open-electronics/RandA/Figures/BlocksStructure.jpg

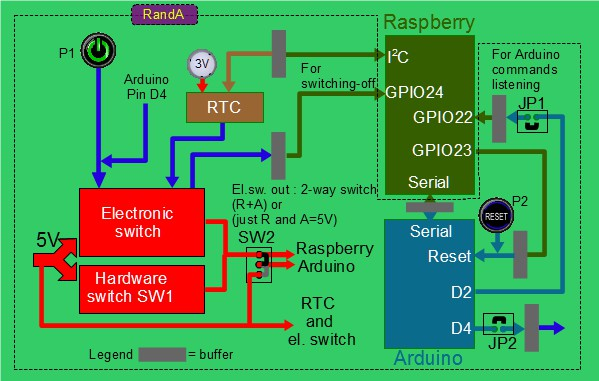
Figures/BlocksStructure.jpg
