open-electronics/RandA/ReadMe.txt

Last Version is V1.5 (use releases tab above to reach the software)
For detailed informations about hardware/software read pdf file

L'ultima versione è la V1.5 (usate il menu <releases> più sopra per raggiungerla)

USARE MENU "tags" o "releasese" PER ACCEDERE ALLE VERSIONI

***************************************************************

PLEASE NOTE that downloading files are in release directory!
So, **for downloading, open menu "releases" (see up there)**. 
This page is intended as a project description.
For this purpose see RandA-en.pdf file for more details.

**Version 1.5 is Raspberry Pi 3 , and Raspbian-jessie compliant**

USES MENU "tags" or "release" FOR VERSIONS LIST AND DOWNLOAD

****************************************************************

ATTENZIONE! Il downloading del software per RandA lo potete
trovare nelle varie cartelle di release.
**Per cui attivate la voce di menù "releases" (che vedete in alto)**.
Questa pagina è usata solo per introdurre il progetto RandA, 
di cui potete avere una visione approfondita tramite il file 
RandA-en.pdf (in Inglese).

**La versione 1.5 è compatibile con Raspberry Pi 3 e con Raspbian-jessie**

****************************************************************

RandA software distribution.

Two software for two environments.
- A zip file for PC. Extract directory (anywhere) on PC and read README.TXT file
  included.
- A zip file for Raspberry. You can copy this file to Raspberry and unzip it 
  there, or you can unzip locally and copy archive and installation script later.
  Read the InstallationREADME.TXT file included.
  
  But since version 1.4 you can download, also, a complete and configured SD image for Raspberry Pi.
  
An handbook with a complete description of RandA (RandA-en.pdf) is included.    

N.B. A copy of PC archive and documentation is also contained in archive for 
Raspberry and extracted to /home/pi/RandA directory for backup. 

These procedures for upgrading your Raspbian OS, already installed, and for upgrading
Arduino IDE, are the shortest software to download (single zip file of about 20M).
But, if you like, you can use a complete Raspbian image (with RandA software)
to download and install, on your SD card.
And you can download, also, the entire Arduino IDE modified.
Using these longer downloads, you are directly operating, without installation
procedure. But you lose your already installed software (if any) and you need to 
install it again.

More info on open-electronics site
http://www.open-electronics.org/tag/randa/
