open-electronics/RandA/Figures/Reset.jpg

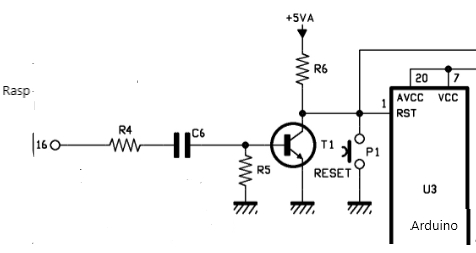
Figures/Reset.jpg
