open-electronics/RandA/Figures/SchematicTot.jpg

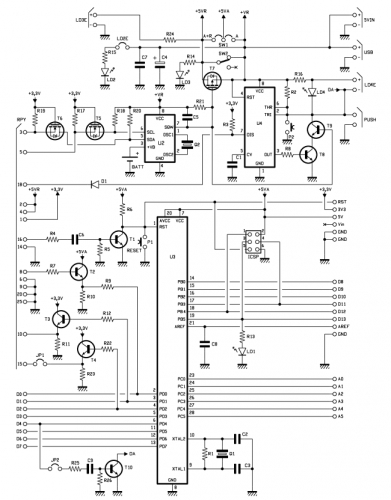
Figures/SchematicTot.jpg
