open-electronics/RandA/(threads)

Thread 1 (2015-06-18):

file remoteport.properties for RandA on Mac machine

gelatmi1, 2015-06-18:
Where i have to copy the file remoteport.properties on a Mac machine (of course if it's possible to use the modified Arduino 1.0.5 on Mac) ?
Thanks

danieledenaro, 2015-06-19:
Same as in Windows environment (where Arduino.exe is executed). I don't know Mac environment so good that I can be sure, but Arduino is a Java based application, so it is portable and directories are the same (I suppose).

gelatmi1, 2015-06-19:
Thanks (grazie) Daniele.
I will try to find the right directorie s.

gelatmi1, 2015-06-27:
Try to instal RandA software on Raspy PI 2 but after reboot i receive a lot of bad messages (like processor 3 stopping) and at the end Kernel stopped with panic alert / not able to mount device ..... and the system is freeze !!!

danieledenaro, 2015-06-27:
xgelatmi1
Try to install RandA software on a new SD with Raspbian. Probably some interaction with other installed software. Or download and use SD image with software installed, on a new SD (via WinDiskImager).
Software has been tested on Raspy Pi 2.

gelatmi1, 2015-06-27:
No other software installed, it is a fresh installation using NOOBS to install it on a 32 GB SD cardI changed only the hostname and added cgroup_enable=memory to file cmdline.txt

Date: Sat, 27 Jun 2015 01:43:24 -0700
From: notifications@github.com
To: RandA@noreply.github.com
CC: gelmir99@hotmail.com
Subject: Re: [RandA] file remoteport.properties for RandA on Mac machine (#1)

xgelatmi1

Try to install RandA software on a new SD with Raspbian. Probably some interaction with other installed software. Or download and use SD image with software installed, on a new SD (via WinDiskImager).

Software has been tested on Raspy Pi 2.

—
Reply to this email directly or view it on GitHub.

danieledenaro, 2015-06-27:
xgelatmi1
Simply, try to disable cgroup (comment line). Not tested with RandA software.
If no more problems, I will investigate about cgroup and RandA (but not immediately).

gelatmi1, 2015-06-27:
i will try this evening but i'm not sure this is the solution because in your procedure this file is substitute with a new one if i remember well
thanks for your help

Date: Sat, 27 Jun 2015 02:15:25 -0700
From: notifications@github.com
To: RandA@noreply.github.com
CC: gelmir99@hotmail.com
Subject: Re: [RandA] file remoteport.properties for RandA on Mac machine (#1)

xgelatmi1

Simply, try to disable cgroup (comment line). Not tested with RandA software.

If no more problems, I will investigate about cgroup and RandA (but not immediately).

—
Reply to this email directly or view it on GitHub.

danieledenaro, 2015-06-27:
xgelatmi1

In any case for people that should have problem with RandA installation procedure, I suggest to try to install on new OS image, or better, to use image already prepared downloaded from github site (release 1.4).
In this way you can add, step by step, software or setting added, and discover possible incompatibilities.
Consider that prepared image has been tested on Rasp 2. So it surely operate without problem.

gelatmi1, 2015-06-27:
Ok, thanks, i will try and i hope all will be solvedthanks again for your work and effort

Date: Sat, 27 Jun 2015 03:35:07 -0700
From: notifications@github.com
To: RandA@noreply.github.com
CC: gelmir99@hotmail.com
Subject: Re: [RandA] file remoteport.properties for RandA on Mac machine (#1)

xgelatmi1

In any case for people that should have problem with RandA installation procedure, I suggest to try to install on new OS image, or better, to use image already prepared downloaded from github site (release 1.4).

In this way you can add, step by step, software or setting added, and discover possible incompatibilities.

Consider that prepared image has been tested on Rasp 2. So it surely operate without problem.

—
Reply to this email directly or view it on GitHub.

Thread 2 (2019-06-26):

Explain how to load a compiled .hex to RandA without any software

Stypox, 2019-06-26:
It makes no sense to download the whole RandA software if only uploading sketches is needed. An explanation on how to do that should be added somewhere. It took me ages to understand what makes it different from a normal Arduino (by reading the RandA scripts), but it all boils down to these lines:

```sh
gpio -g write 23 0
sleep 0.1
gpio -g write 23 1
#   ...   UPLOAD .hex USING ANY METHOD (the best one is probably arduino-cli)
gpio -g write 23 0
```

###### [arduino-cli](https://github.com/arduino/arduino-cli)

Stypox, 2019-06-29:
Forgot to add the `install.sh` code to setup the serial connection (to be executed once)
```
 

# enable i2c (if not already enabled)

check=$(grep -c "^dtparam=i2c_arm" /boot/config.txt)

if [ x$check == x"0" ]

then

sudo su -c 'echo -e "\n#enable i2c\ndtparam=i2c_arm=on" >> /boot/config.txt'

fi

# enable serial on GPIO14,15 (if not already enabled)

check=$(grep -c "^dtoverlay=pi3-miniuart-bt" /boot/config.txt)

if [ x$check == x"0" ]

then

sudo su -c 'echo -e "\n#switch serial1 with serial0\ndtoverlay=pi3-miniuart-bt" >> /boot/config.txt'

fi

# serial will be not a console terminal (because it will be used by RandA)

sudo su -c 'echo -e "dwc_otg.lpm_enable=0 console=tty1 root=/dev/mmcblk0p2 rootfstype=ext4 elevator=deadline fsck.repair=yes rootwait" > /boot/cmdline.txt'

# execute on startup: /etc/rc.local

sudo su -c 'sed -i "/^exit 0/ d" /etc/rc.local'
sudo su -c 'echo -e "\n# RandA serial port\n# serial no terminal\nchmod 777 /dev/ttyAMA0\n# synonym for Arduino serial port\nln -s /dev/ttyAMA0 /dev/Arduino\n\n# enable RandA reset via GPIO 23\n# soft reset pin initialization\ngpio -g mode 23 out\n\nexit 0" >> /etc/rc.local'```
