open-electronics/RandA/(commit log)

2015-03-31 Create RandA on Raspberry Pi 2
2015-03-31 Update RandA on Raspberry Pi 2
2015-06-16 Rename RandA on Raspberry Pi 2 to RandAV1.3 on Rasberry2 (OBSOLETE)
2015-06-16 Create NewVersion 1.4 Raspberry Pi 2 compatible
